uwtron2022/thermo-force/_WeightFeedback/Images/BT+MotorTesting Circuits.jpg

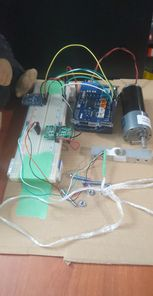
_WeightFeedback/Images/BT+MotorTesting Circuits.jpg
