uwtron2022/thermo-force/_WeightFeedback/Images/BT_PhoneSide.png

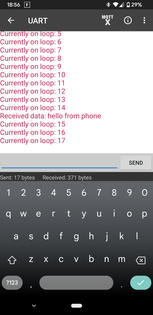
_WeightFeedback/Images/BT_PhoneSide.png
