uwtron2022/thermo-force/_WeightFeedback/Text Documents/MotorForceCurve.txt

force(g) = -0.193653746459857(pwm^2)+113.4054878614721(pwm)-3686.540551147551
33<=pwm<=192
0<=force<=11,058
