uwtron2022/thermo-force/_WeightFeedback/Text Documents/StallMotorCurrent.txt

pwmCmd: 0, avgMotCurrent: 0.00
pwmCmd: 1, avgMotCurrent: 0.00
pwmCmd: 2, avgMotCurrent: 0.00
pwmCmd: 3, avgMotCurrent: 0.00
pwmCmd: 4, avgMotCurrent: 0.00
pwmCmd: 5, avgMotCurrent: 0.00
pwmCmd: 6, avgMotCurrent: 0.00
pwmCmd: 7, avgMotCurrent: 0.10
pwmCmd: 8, avgMotCurrent: 0.00
pwmCmd: 9, avgMotCurrent: 0.08
pwmCmd: 10, avgMotCurrent: 0.00
pwmCmd: 11, avgMotCurrent: 0.00
pwmCmd: 12, avgMotCurrent: 0.15
pwmCmd: 13, avgMotCurrent: 0.00
pwmCmd: 14, avgMotCurrent: 0.13
pwmCmd: 15, avgMotCurrent: 0.00
pwmCmd: 16, avgMotCurrent: 0.00
pwmCmd: 17, avgMotCurrent: 0.15
pwmCmd: 18, avgMotCurrent: 0.00
pwmCmd: 19, avgMotCurrent: 0.12
pwmCmd: 20, avgMotCurrent: 0.00
pwmCmd: 21, avgMotCurrent: 0.13
pwmCmd: 22, avgMotCurrent: 0.01
pwmCmd: 23, avgMotCurrent: 0.00
pwmCmd: 24, avgMotCurrent: 0.28
pwmCmd: 25, avgMotCurrent: 0.15
pwmCmd: 26, avgMotCurrent: 0.27
pwmCmd: 27, avgMotCurrent: 0.14
pwmCmd: 28, avgMotCurrent: 0.27
pwmCmd: 29, avgMotCurrent: 0.19
pwmCmd: 30, avgMotCurrent: 0.28
pwmCmd: 31, avgMotCurrent: 0.20
pwmCmd: 32, avgMotCurrent: 0.39
pwmCmd: 33, avgMotCurrent: 0.27
pwmCmd: 34, avgMotCurrent: 0.35
pwmCmd: 35, avgMotCurrent: 0.26
pwmCmd: 36, avgMotCurrent: 0.19
pwmCmd: 37, avgMotCurrent: 0.28
pwmCmd: 38, avgMotCurrent: 0.22
pwmCmd: 39, avgMotCurrent: 0.43
pwmCmd: 40, avgMotCurrent: 0.25
pwmCmd: 41, avgMotCurrent: 0.57
pwmCmd: 42, avgMotCurrent: 0.44
pwmCmd: 43, avgMotCurrent: 0.27
pwmCmd: 44, avgMotCurrent: 0.63
pwmCmd: 45, avgMotCurrent: 0.20
pwmCmd: 46, avgMotCurrent: 0.29
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
pwmCmd: 247, avgMotCurrent: 4.70
pwmCmd: 248, avgMotCurrent: 4.75
pwmCmd: 249, avgMotCurrent: 4.76
pwmCmd: 250, avgMotCurrent: 4.75
pwmCmd: 251, avgMotCurrent: 4.69
pwmCmd: 252, avgMotCurrent: 4.80
pwmCmd: 253, avgMotCurrent: 4.83
pwmCmd: 254, avgMotCurrent: 4.85
pwmCmd: 255, avgMotCurrent: 4.88
