uwtron2022/thermo-force/_WeightFeedback/Images/BT_ArduinoSide.png

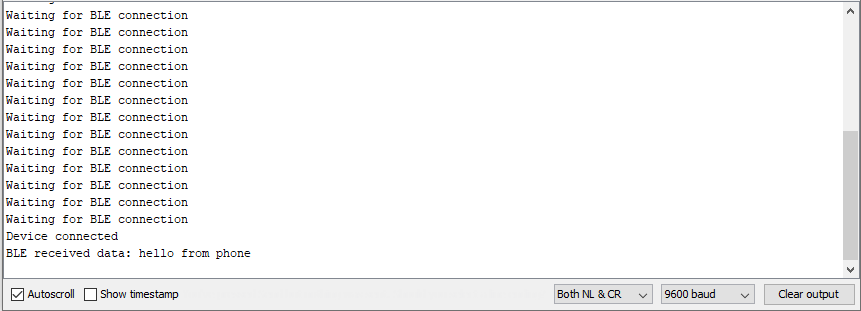
_WeightFeedback/Images/BT_ArduinoSide.png
