uwtron2022/thermo-force/_WeightFeedback/Images/WeightFeedbackCircuit.png

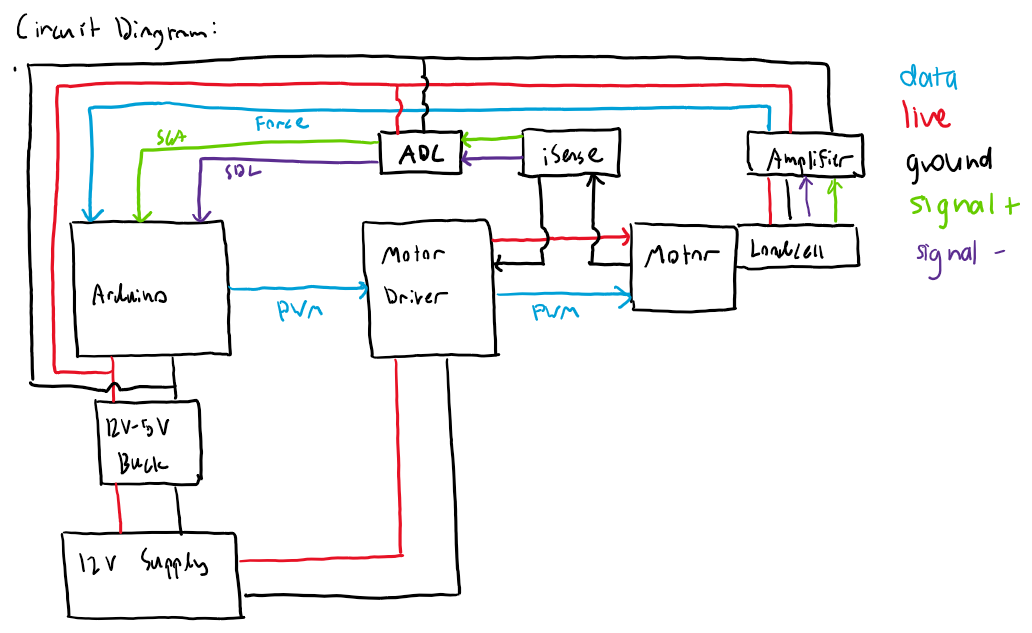
_WeightFeedback/Images/WeightFeedbackCircuit.png
