uwtron2022/thermo-force/_WeightFeedback/Images/WeightFeedbackControlLoop.png

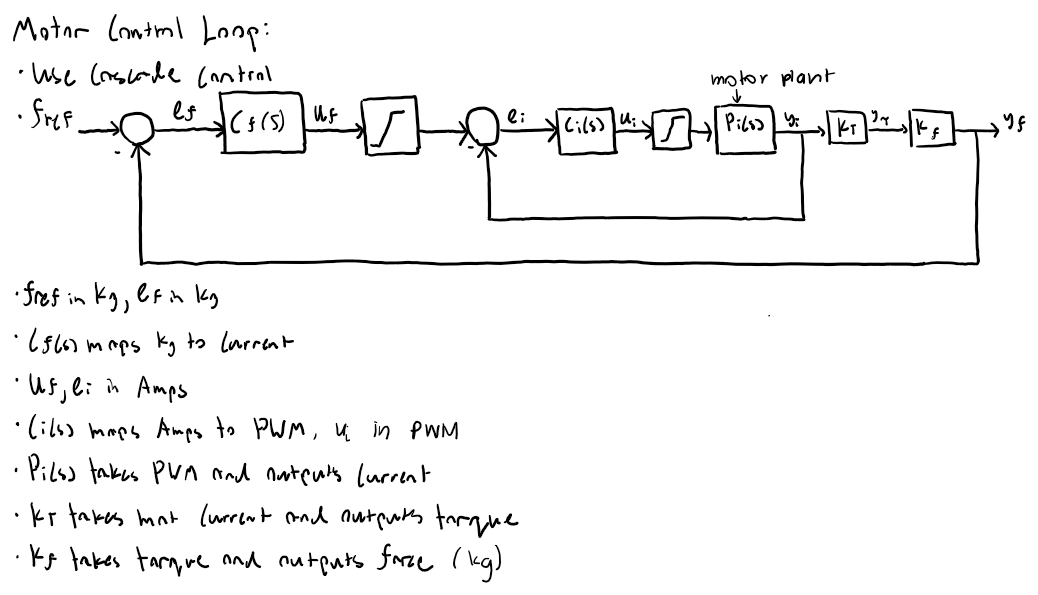
_WeightFeedback/Images/WeightFeedbackControlLoop.png
