uwtron2022/thermo-force/_WeightFeedback/Images/WeightFeedbackMotorSelection.png

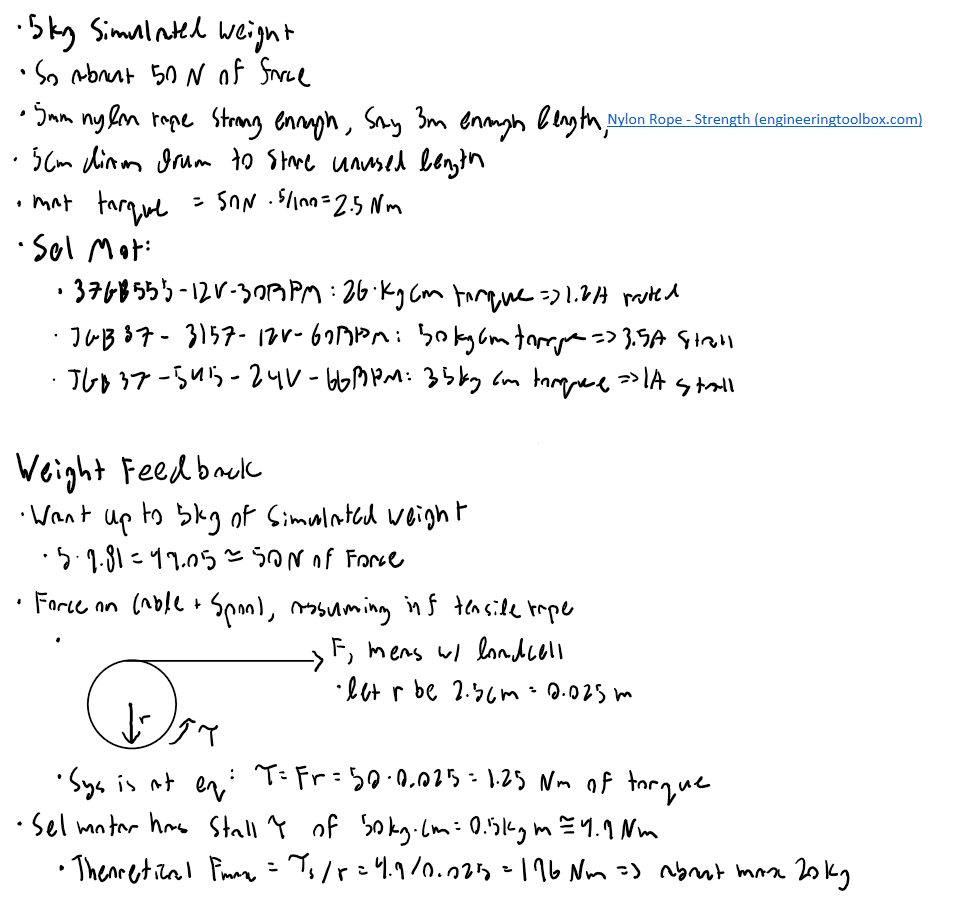
_WeightFeedback/Images/WeightFeedbackMotorSelection.png
