uwtron2022/thermo-force/_WeightFeedback/Text Documents/MotorCharacterization.xlsx

Ra |  |  | La |  |  |  | Ke = Kt |  |  |  | Stiction, Bt |  |  |  | Jt
-No speed reducer, no pulley -Apply 1V, stall motor -Measure current -Repeat for 2V, 3V '-Calculate Ra = Va/Ia and average |  |  | -No speed reducer, no pulley -1VPP, 30Hz sin wave applied to armature -Measure AC current -Calc Imp = Vac(RMS)/Iac(RMS) -Calc Reac = sqrt(Imp^2-R^2) -L = Reac/(120*Pi) |  |  |  | -Speed reducer, pulley -Apply 9V to armature -Measure current -Measure speed in RPM, convert to rad/s. -Ke = Kt then equals (Va-RaIa)/Wm |  |  |  | -Speed reducer, pulley -Apply 6V, measure RPM (convert to rad/s), measure current -Repeat for 9V -Find torque using Tm = Ia*Kt -Plot both points, slope is B, intercept is Stiction |  |  |  | -Speed reducer, pulley -Apply 9V to armature -Wait for steady state, measure Ia, Wm -Disable driver output -Measure Wm right after turning off inverter
Va | Ia | Ra |  |  |  |  | Va | Ra | Ia | RPM
1 | 0.658 | 1.519756839 | Va(RMS) | Ia(RMS) | Z | Ra | 6 | 1.595184209 | 0.26 | 44.4
2 | 1.21 | 1.652892562 | 0.707 | 0.006356 | 111.2334802 | 1.519756839 |  |  |  |  | Va | Ia | Tm | Wm | Va | Ia | Wm | Tm
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
