uwtron2022/thermo-force/(commit log)

2022-02-07 Add weight feedback files
    [MotorCharacterization.xlsx, MotorParameters.xlsx, PWMtoForceEQ.xlsx]
2022-02-07 Add electrical mount files, minus full assembly
    [0.125in-1in-6in_SteelBar.SLDPRT, 12V_60RPM_BLDCMotor.SLDPRT, 1PinMaleHeader.SLDPRT, 1x2 Male Pin Header.STEP, 1x3 Male Pin Header.STEP, 1x4 Male Pin Header.STEP, 1x5 Male Pin Header.STEP, 1x6 Male Pin Header.STEP]
2022-02-07 Added full system assembly
2022-02-08 BoM Creation
    [0.125in-1in-6in_SteelBar.SLDPRT, 0.25in Eye Bolt.SLDPRT, Adafruit_20KgLoadcell.SLDPRT, BatteryMount.SLDASM, BoM.xlsx, M4x10 Bolt.SLDPRT, M4x12 Bolt.SLDPRT, M4x16 Bolt.SLDPRT]
2022-02-10 Updated solidworks files
    [0.125in-1in-6in_SteelBar.SLDDRW, 0.125in-1in-6in_SteelBar.SLDPRT, 0.25in Eye Bolt.SLDPRT, 12V_60RPM_BLDCMotor.SLDPRT, 2-Port Relay.SLDPRT, 3x7PerfBoard.SLDPRT, 4-Port Relay.SLDPRT, 5mm2PTerminalBlock.SLDPRT]
2022-03-02 Fuzzy logic controller implemented
    [0.125in-1in-6in_SteelBar.SLDDRW, 12V_60RPM_BLDCMotor.SLDPRT, Adafruit_20KgLoadcellArms.SLDDRW, CableGuide.SLDPRT, MotorMount.SLDASM]
2022-03-05 updated from friday integration
    [12V_60RPM_BLDCMotor.SLDPRT, CableGuide.SLDPRT]
2022-03-05 Added SW files
    [CableGuide_Part1.SLDPRT, CableGuide_Part1.STL, CableGuide_Part2.SLDPRT, CableGuide_Part2.STL, DCMotorMount.SLDPRT, DCMotorMount.STL, MotorPulley.SLDPRT, MotorPulley.STL]
2022-03-06 Arduino Files w/ Comms (Serial)
2022-03-07 Ready for demo - TEMP CONTROL IS COMMENTED OUT,
    DEMO WEIGHT CONTROL FIRST, UNCOMMENT TEMPERATURE, DEMO TEMPERATURE
